Zepheus/opentherm_heating_controller/docs/BOM.md

# Andiron v1.0 — bill of materials

Generated by `tools/bom.py` from the schematic on 2026-10-22. Prices: LCSC single-unit prices from the JLCPCB parts database snapshot of 2026-10-20; they are estimates, not a quote. Upload file for JLCPCB assembly: [`bom/andiron-bom-jlc.csv`](bom/andiron-bom-jlc.csv) (fitted parts only; the placement file comes from the board).

## Cost summary

| Item | USD |
|---|---:|
| Components per board (92 placements, 39 unique parts) | 15.96 |
| Extended-part loading fees per order (13 × $3.00, assumed) | 39.00 |
| **Components per board at 5 boards, fees included** | **23.76** |

PCB fabrication, assembly setup, through-hole soldering, stencil and shipping are not included; take them from the JLCPCB quote. The Library column is what the parts database reports; "Preferred" parts carry no loading fee on Economic assembly, so only "Extended" parts are counted. Swapping an Extended part for a Basic or Preferred equivalent saves its fee.

## Fitted parts

| Qty | References | Value | Footprint | LCSC | Manufacturer part | Library | Unit | Line |
|---:|---|---|---|---|---|---|---:|---:|
| 1 | C1 | 1nF | C_0603_1608Metric | [C1588](https://jlcpcb.com/partdetail/C1588) | Samsung Electro-Mechanics CL10B102KB8NNNC | Basic | 0.0090 | 0.01 |
| 1 | C2 | 470uF/16V | CP_Elec_8x10 | [C3341](https://jlcpcb.com/partdetail/C3341) | Honor Elec RVT1C471M0810 | Extended | 0.0650 | 0.07 |
| 2 | C3, C4 | 10uF | C_0805_2012Metric | [C15850](https://jlcpcb.com/partdetail/C15850) | Samsung Electro-Mechanics CL21A106KAYNNNE | Basic | 0.0440 | 0.09 |
| 4 | C5, C7, C9, C10 | 100nF | C_0603_1608Metric | [C14663](https://jlcpcb.com/partdetail/C14663) | YAGEO CC0603KRX7R9BB104 | Basic | 0.0110 | 0.04 |
| 1 | C6 | 22uF | C_0805_2012Metric | [C45783](https://jlcpcb.com/partdetail/C45783) | Samsung Electro-Mechanics CL21A226MAQNNNE | Basic | 0.1940 | 0.19 |
| 1 | C8 | 1uF | C_0603_1608Metric | [C15849](https://jlcpcb.com/partdetail/C15849) | Samsung Electro-Mechanics CL10A105KB8NNNC | Basic | 0.0140 | 0.01 |
| 2 | D1, D2 | SMF5.0A | D_SOD-123F | [C19077497](https://jlcpcb.com/partdetail/C19077497) | hongjiacheng SMF5.0A | Preferred | 0.0280 | 0.06 |
| 8 | D101, D102, D103, D104, D201, D202, D203, D204 | 1N4148WS | D_SOD-323 | [C2128](https://jlcpcb.com/partdetail/C2128) | Jiangsu Changjing Electronics Technology Co., Ltd. 1N4148WS | Basic | 0.0150 | 0.12 |
| 1 | D205 | 4V7 BZT52C4V7 | D_SOD-123 | [C19077400](https://jlcpcb.com/partdetail/C19077400) | hongjiacheng BZT52C4V7 | Preferred | 0.0120 | 0.01 |
| 1 | D206 | 15V BZT52C15 | D_SOD-123 | [C19077412](https://jlcpcb.com/partdetail/C19077412) | hongjiacheng BZT52C15 | Preferred | 0.0180 | 0.02 |
| 1 | D207 | 4V3 BZT52C4V3 | D_SOD-123 | [C19077399](https://jlcpcb.com/partdetail/C19077399) | hongjiacheng BZT52C4V3 | Preferred | 0.0180 | 0.02 |
| 1 | D208 | SMAJ24A | D_SMA | [C19077541](https://jlcpcb.com/partdetail/C19077541) | hongjiacheng SMAJ24A | Preferred | 0.0380 | 0.04 |
| 1 | F201 | 1A 250V fast | Fuse_Littelfuse-NANO2-451_453 | [C83798](https://jlcpcb.com/partdetail/C83798) | AEM MF2410F1.000TM | Extended | 0.0930 | 0.09 |
| 1 | J1 | USB-C 16P | USB_C_Receptacle_HRO_TYPE-C-31-M-12 | [C165948](https://jlcpcb.com/partdetail/C165948) | Korean Hroparts Elec TYPE-C-31-M-12 | Extended | 0.1860 | 0.19 |
| 2 | J3, J4 | FLOW / OUTDOOR | CONN-TH_3P-P3.50_KF350-3.5-3P | [C474893](https://jlcpcb.com/partdetail/C474893) | Cixi Kefa Elec KF350-3.5-3P | Extended | 0.1550 | 0.31 |
| 2 | J5, J6 | OLED (Qwiic) GND/3V3/SDA/SCL / QWIIC | JST_SH_SM04B-SRSS-TB_1x04-1MP_P1.00mm_Horizontal | [C160404](https://jlcpcb.com/partdetail/C160404) | JST SM04B-SRSS-TB(LF)(SN) | Extended | 0.2140 | 0.43 |
| 1 | J7 | SPARE GPIO | PinHeader_1x08_P2.54mm_Vertical | [C492407](https://jlcpcb.com/partdetail/C492407) | XFCN PZ254V-11-08P | Extended | 0.0520 | 0.05 |
| 4 | J111, J112, J113, J114 | CH1 NC/COM/NO / CH2 NC/COM/NO / CH3 NC/COM/NO / CH4 NC/COM/NO | CONN-TH_3P-P5.00_WJ128V-5.0-3P | [C8270](https://jlcpcb.com/partdetail/C8270) | Ningbo Kangnex Elec WJ128V-5.0-03P-14-00A | Extended | 0.2090 | 0.84 |
| 1 | J201 | OT (24V max) | CONN-TH_P3.50_KF350-3.5-2P | [C474892](https://jlcpcb.com/partdetail/C474892) | Cixi Kefa Elec KF350-3.5-2P | Extended | 0.1190 | 0.12 |
| 4 | K101, K102, K103, K104 | RT314005 | RELAY-TH_RT314005_HF115F-PINS | [C7065270](https://jlcpcb.com/partdetail/C7065270) | TE Connectivity RT314005 | Extended | 1.8920 | 7.57 |
| 6 | LED1, LED2, LED101, LED102, LED103, LED104 | STATUS / OT_ACT / K1 / K2 / K3 / K4 | LED_0603_1608Metric | [C2286](https://jlcpcb.com/partdetail/C2286) | Hubei KENTO Elec KT-0603R | Basic | 0.0080 | 0.05 |
| 4 | Q101, Q102, Q103, Q104 | AO3400A | SOT-23 | [C20917](https://jlcpcb.com/partdetail/C20917) | Alpha & Omega Semicon AO3400A | Basic | 0.0970 | 0.39 |
| 1 | Q201 | S8550 | SOT-23 | [C105432](https://jlcpcb.com/partdetail/C105432) | Jiangsu Changjing Electronics Technology Co., Ltd. S8550(RANGE:120-200) | Basic | 0.0170 | 0.02 |
| 2 | R1, R2 | 5.1k | R_0603_1608Metric | [C23186](https://jlcpcb.com/partdetail/C23186) | UNI-ROYAL(Uniroyal Elec) 0603WAF5101T5E | Basic | 0.0020 | 0.00 |
| 1 | R3 | 1M | R_0603_1608Metric | [C22935](https://jlcpcb.com/partdetail/C22935) | UNI-ROYAL(Uniroyal Elec) 0603WAF1004T5E | Basic | 0.0020 | 0.00 |
| 6 | R4, R5, R6, R7, R9, R11 | 10k | R_0603_1608Metric | [C25804](https://jlcpcb.com/partdetail/C25804) | UNI-ROYAL(Uniroyal Elec) 0603WAF1002T5E | Basic | 0.0020 | 0.01 |
| 6 | R8, R10, R113, R123, R133, R143 | 1k | R_0603_1608Metric | [C21190](https://jlcpcb.com/partdetail/C21190) | UNI-ROYAL(Uniroyal Elec) 0603WAF1001T5E | Basic | 0.0030 | 0.02 |
| 3 | R12, R13, R14 | 4.7k | R_0603_1608Metric | [C23162](https://jlcpcb.com/partdetail/C23162) | UNI-ROYAL(Uniroyal Elec) 0603WAF4701T5E | Basic | 0.0030 | 0.01 |
| 2 | R15, R204 | 330 | R_0603_1608Metric | [C23138](https://jlcpcb.com/partdetail/C23138) | UNI-ROYAL(Uniroyal Elec) 0603WAF3300T5E | Basic | 0.0020 | 0.00 |
| 5 | R111, R121, R131, R141, R203 | 100 | R_0603_1608Metric | [C22775](https://jlcpcb.com/partdetail/C22775) | UNI-ROYAL(Uniroyal Elec) 0603WAF1000T5E | Basic | 0.0030 | 0.01 |
| 4 | R112, R122, R132, R142 | 100k | R_0603_1608Metric | [C25803](https://jlcpcb.com/partdetail/C25803) | UNI-ROYAL(Uniroyal Elec) 0603WAF1003T5E | Basic | 0.0030 | 0.01 |
| 1 | R201 | 330 | R_1206_3216Metric | [C17930](https://jlcpcb.com/partdetail/C17930) | UNI-ROYAL(Uniroyal Elec) 1206W4F3300T5E | Extended | 0.0050 | 0.01 |
| 1 | R202 | 220 | R_0603_1608Metric | [C22962](https://jlcpcb.com/partdetail/C22962) | UNI-ROYAL(Uniroyal Elec) 0603WAF2200T5E | Basic | 0.0030 | 0.00 |
| 1 | R205 | 1.5k | R_0603_1608Metric | [C22843](https://jlcpcb.com/partdetail/C22843) | UNI-ROYAL(Uniroyal Elec) 0603WAF1501T5E | Basic | 0.0020 | 0.00 |
| 4 | SW1, SW2, SW3, SW4 | RESET / BOOT / BTN1 / BTN2 | SW-SMD_4P-L5.1-W5.1-P3.70-LS6.5-TL_H1.5 | [C318884](https://jlcpcb.com/partdetail/C318884) | XKB Connection TS-1187A-B-A-B | Basic | 0.0210 | 0.08 |
| 1 | U1 | ESP32-C6-WROOM-1-N8 | WIRELM-SMD_ESP32-C6-WROOM-1 | [C5366877](https://jlcpcb.com/partdetail/C5366877) | Espressif Systems ESP32-C6-WROOM-1-N8 | Extended | 4.2330 | 4.23 |
| 1 | U2 | LDL1117S33R | SOT-223-3_TabPin2 | [C435835](https://jlcpcb.com/partdetail/C435835) | STMicroelectronics LDL1117S33R | Extended | 0.5010 | 0.50 |
| 1 | U3 | USBLC6-2SC6 | SOT-23-6 | [C7519](https://jlcpcb.com/partdetail/C7519) | STMicroelectronics USBLC6-2SC6 | Extended | 0.1770 | 0.18 |
| 2 | U201, U202 | LTV-817S (TX) / LTV-817S (RX) | OPTO-SMD-4_L4.6-W6.5-P2.54-LS10.3-BL | [C109227](https://jlcpcb.com/partdetail/C109227) | Lite-On LTV-817S-TA1-C | Basic | 0.0790 | 0.16 |

## Not fitted (DNP)

| Reference | Value | Why it is on the board |
|---|---|---|
