Zepheus/opentherm_heating_controller/docs/bom/andiron-bom-jlc.csv

Comment | Designator | Footprint | LCSC
1nF | C1 | C_0603_1608Metric | C1588
470uF/16V | C2 | CP_Elec_8x10 | C3341
10uF | C3,C4 | C_0805_2012Metric | C15850
100nF | C5,C7,C9,C10 | C_0603_1608Metric | C14663
22uF | C6 | C_0805_2012Metric | C45783
1uF | C8 | C_0603_1608Metric | C15849
SMF5.0A | D1,D2 | D_SOD-123F | C19077497
1N4148WS | D101,D102,D103,D104,D201,D202,D203,D204 | D_SOD-323 | C2128
4V7 BZT52C4V7 | D205 | D_SOD-123 | C19077400
15V BZT52C15 | D206 | D_SOD-123 | C19077412
4V3 BZT52C4V3 | D207 | D_SOD-123 | C19077399
SMAJ24A | D208 | D_SMA | C19077541
1A 250V fast | F201 | Fuse_Littelfuse-NANO2-451_453 | C83798
USB-C 16P | J1 | USB_C_Receptacle_HRO_TYPE-C-31-M-12 | C165948
FLOW / OUTDOOR | J3,J4 | CONN-TH_3P-P3.50_KF350-3.5-3P | C474893
OLED (Qwiic) GND/3V3/SDA/SCL / QWIIC | J5,J6 | JST_SH_SM04B-SRSS-TB_1x04-1MP_P1.00mm_Horizontal | C160404
SPARE GPIO | J7 | PinHeader_1x08_P2.54mm_Vertical | C492407
CH1 NC/COM/NO / CH2 NC/COM/NO / CH3 NC/COM/NO / CH4 NC/COM/NO | J111,J112,J113,J114 | CONN-TH_3P-P5.00_WJ128V-5.0-3P | C8270
OT (24V max) | J201 | CONN-TH_P3.50_KF350-3.5-2P | C474892
RT314005 | K101,K102,K103,K104 | RELAY-TH_RT314005_HF115F-PINS | C7065270
STATUS / OT_ACT / K1 / K2 / K3 / K4 | LED1,LED2,LED101,LED102,LED103,LED104 | LED_0603_1608Metric | C2286
AO3400A | Q101,Q102,Q103,Q104 | SOT-23 | C20917
S8550 | Q201 | SOT-23 | C105432
5.1k | R1,R2 | R_0603_1608Metric | C23186
1M | R3 | R_0603_1608Metric | C22935
10k | R4,R5,R6,R7,R9,R11 | R_0603_1608Metric | C25804
1k | R8,R10,R113,R123,R133,R143 | R_0603_1608Metric | C21190
4.7k | R12,R13,R14 | R_0603_1608Metric | C23162
330 | R15,R204 | R_0603_1608Metric | C23138
100 | R111,R121,R131,R141,R203 | R_0603_1608Metric | C22775
100k | R112,R122,R132,R142 | R_0603_1608Metric | C25803
330 | R201 | R_1206_3216Metric | C17930
220 | R202 | R_0603_1608Metric | C22962
1.5k | R205 | R_0603_1608Metric | C22843
RESET / BOOT / BTN1 / BTN2 | SW1,SW2,SW3,SW4 | SW-SMD_4P-L5.1-W5.1-P3.70-LS6.5-TL_H1.5 | C318884
ESP32-C6-WROOM-1-N8 | U1 | WIRELM-SMD_ESP32-C6-WROOM-1 | C5366877
LDL1117S33R | U2 | SOT-223-3_TabPin2 | C435835
USBLC6-2SC6 | U3 | SOT-23-6 | C7519
LTV-817S (TX) / LTV-817S (RX) | U201,U202 | OPTO-SMD-4_L4.6-W6.5-P2.54-LS10.3-BL | C109227
