Zepheus/opentherm_heating_controller/heating-controller.kicad_pcb

## KiCad design heating-controller.kicad_pcb (2026-10-22)

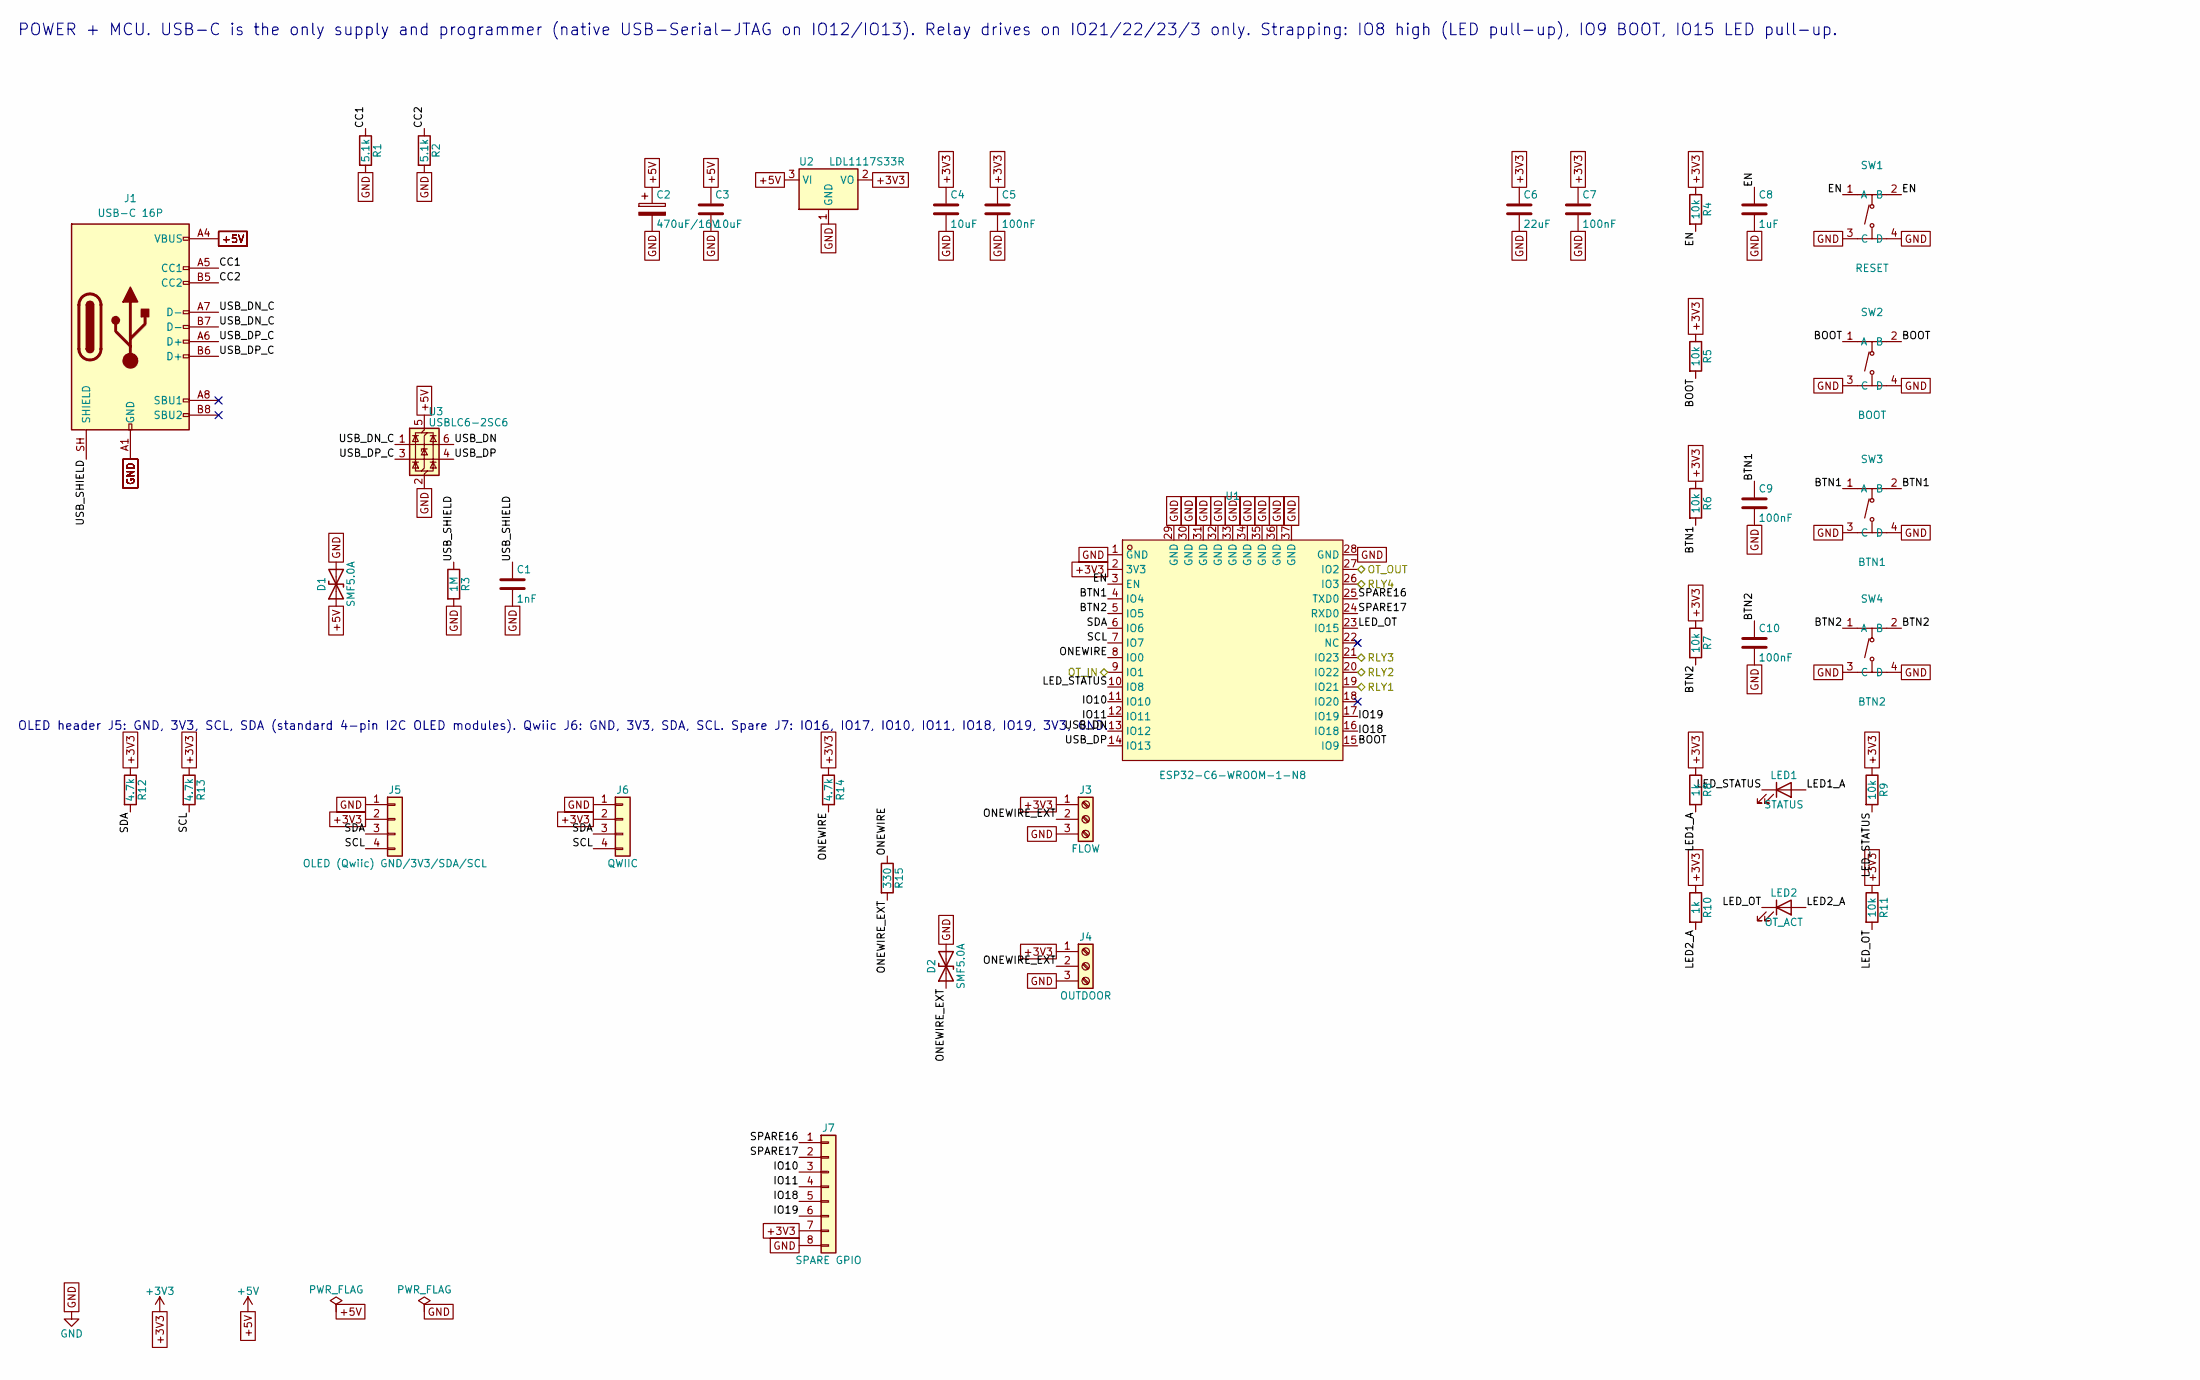
[picture p10: schematic power_mcu.kicad_sch, Andiron]

Parts:
C1: 1nF; C_0603_1608Metric; LCSC C1588
C2: 470uF/16V; CP_Elec_8x10; LCSC C3341
C3, C4: 10uF; C_0805_2012Metric; LCSC C15850
C5, C7, C9, C10: 100nF; C_0603_1608Metric; LCSC C14663
C6: 22uF; C_0805_2012Metric; LCSC C45783
C8: 1uF; C_0603_1608Metric; LCSC C15849
D1, D2: SMF5.0A; D_SOD-123F; LCSC C19077497
J1: USB-C 16P; USB_C_Receptacle_HRO_TYPE-C-31-M-12; LCSC C165948
J3: FLOW; CONN-TH_3P-P3.50_KF350-3.5-3P; LCSC C474893
J4: OUTDOOR; CONN-TH_3P-P3.50_KF350-3.5-3P; LCSC C474893
J5: OLED (Qwiic) GND/3V3/SDA/SCL; JST_SH_SM04B-SRSS-TB_1x04-1MP_P1.00mm_Horizontal; LCSC C160404
J6: QWIIC; JST_SH_SM04B-SRSS-TB_1x04-1MP_P1.00mm_Horizontal; LCSC C160404
J7: SPARE GPIO; PinHeader_1x08_P2.54mm_Vertical; LCSC C492407
LED1: STATUS; LED_0603_1608Metric; LCSC C2286
LED2: OT_ACT; LED_0603_1608Metric; LCSC C2286
R1, R2: 5.1k; R_0603_1608Metric; LCSC C23186
R3: 1M; R_0603_1608Metric; LCSC C22935
R4, R5, R6, R7, R9, R11: 10k; R_0603_1608Metric; LCSC C25804
R8, R10: 1k; R_0603_1608Metric; LCSC C21190
R12, R13, R14: 4.7k; R_0603_1608Metric; LCSC C23162
R15: 330; R_0603_1608Metric; LCSC C23138
SW1: RESET; SW-SMD_4P-L5.1-W5.1-P3.70-LS6.5-TL_H1.5; LCSC C318884
SW2: BOOT; SW-SMD_4P-L5.1-W5.1-P3.70-LS6.5-TL_H1.5; LCSC C318884
SW3: BTN1; SW-SMD_4P-L5.1-W5.1-P3.70-LS6.5-TL_H1.5; LCSC C318884
SW4: BTN2; SW-SMD_4P-L5.1-W5.1-P3.70-LS6.5-TL_H1.5; LCSC C318884
U1: ESP32-C6-WROOM-1-N8; WIRELM-SMD_ESP32-C6-WROOM-1; LCSC C5366877
U2: LDL1117S33R; SOT-223-3_TabPin2; LCSC C435835
U3: USBLC6-2SC6; SOT-23-6; LCSC C7519

Connections:
+3V3: C4.1, C5.1, C6.1, C7.1, J3.1, J4.1, J5.2, J6.2, J7.7, R4.1, R5.1, R6.1, R7.1, R8.1, R9.1, R10.1, R11.1, R12.1, R13.1, R14.1, U1.2 (3V3), U2.2 (VO); also elsewhere on the board
/OT_IN: U1.9 (IO1); also elsewhere on the board
/OT_OUT: U1.27 (IO2); also elsewhere on the board
/Power + MCU/BOOT: R5.2, SW2.1 (A), SW2.2 (B), U1.15 (IO9)
/Power + MCU/BTN1: C9.1, R6.2, SW3.1 (A), SW3.2 (B), U1.4 (IO4)
/Power + MCU/BTN2: C10.1, R7.2, SW4.1 (A), SW4.2 (B), U1.5 (IO5)
/Power + MCU/CC1: J1.A5 (CC1), R1.1
/Power + MCU/CC2: J1.B5 (CC2), R2.1
/Power + MCU/EN: C8.1, R4.2, SW1.1 (A), SW1.2 (B), U1.3 (EN)
/Power + MCU/IO10: J7.3, U1.11 (IO10)
/Power + MCU/IO11: J7.4, U1.12 (IO11)
/Power + MCU/IO18: J7.5, U1.16 (IO18)
/Power + MCU/IO19: J7.6, U1.17 (IO19)
/Power + MCU/LED1_A: LED1.2 (A), R8.2
/Power + MCU/LED2_A: LED2.2 (A), R10.2
/Power + MCU/LED_OT: LED2.1 (K), R11.2, U1.23 (IO15)
/Power + MCU/LED_STATUS: LED1.1 (K), R9.2, U1.10 (IO8)
/Power + MCU/ONEWIRE: R14.2, R15.1, U1.8 (IO0)
/Power + MCU/ONEWIRE_EXT: D2.1 (A1), J3.2, J4.2, R15.2
/Power + MCU/SCL: J5.4, J6.4, R13.2, U1.7 (IO7)
/Power + MCU/SDA: J5.3, J6.3, R12.2, U1.6 (IO6)
/Power + MCU/SPARE16: J7.1, U1.25 (TXD0)
/Power + MCU/SPARE17: J7.2, U1.24 (RXD0)
/Power + MCU/USB_DN: U1.13 (IO12), U3.6 (I/O1)
/Power + MCU/USB_DN_C: J1.A7 (D-), J1.B7 (D-), U3.1 (I/O1)
/Power + MCU/USB_DP: U1.14 (IO13), U3.4 (I/O2)
/Power + MCU/USB_DP_C: J1.A6 (D+), J1.B6 (D+), U3.3 (I/O2)
/Power + MCU/USB_SHIELD: C1.1, J1.SH (SHIELD), R3.1
/RLY1: U1.19 (IO21); also elsewhere on the board
/RLY2: U1.20 (IO22); also elsewhere on the board
/RLY3: U1.21 (IO23); also elsewhere on the board
/RLY4: U1.26 (IO3); also elsewhere on the board

Notes on the sheet:
POWER + MCU. USB-C is the only supply and programmer (native USB-Serial-JTAG on IO12/IO13). Relay drives on IO21/22/23/3 only. Strapping: IO8 high (LED pull-up), IO9 BOOT, IO15 LED pull-up.
OLED header J5: GND, 3V3, SCL, SDA (standard 4-pin I2C OLED modules). Qwiic J6: GND, 3V3, SDA, SCL. Spare J7: IO16, IO17, IO10, IO11, IO18, IO19, 3V3, GND.

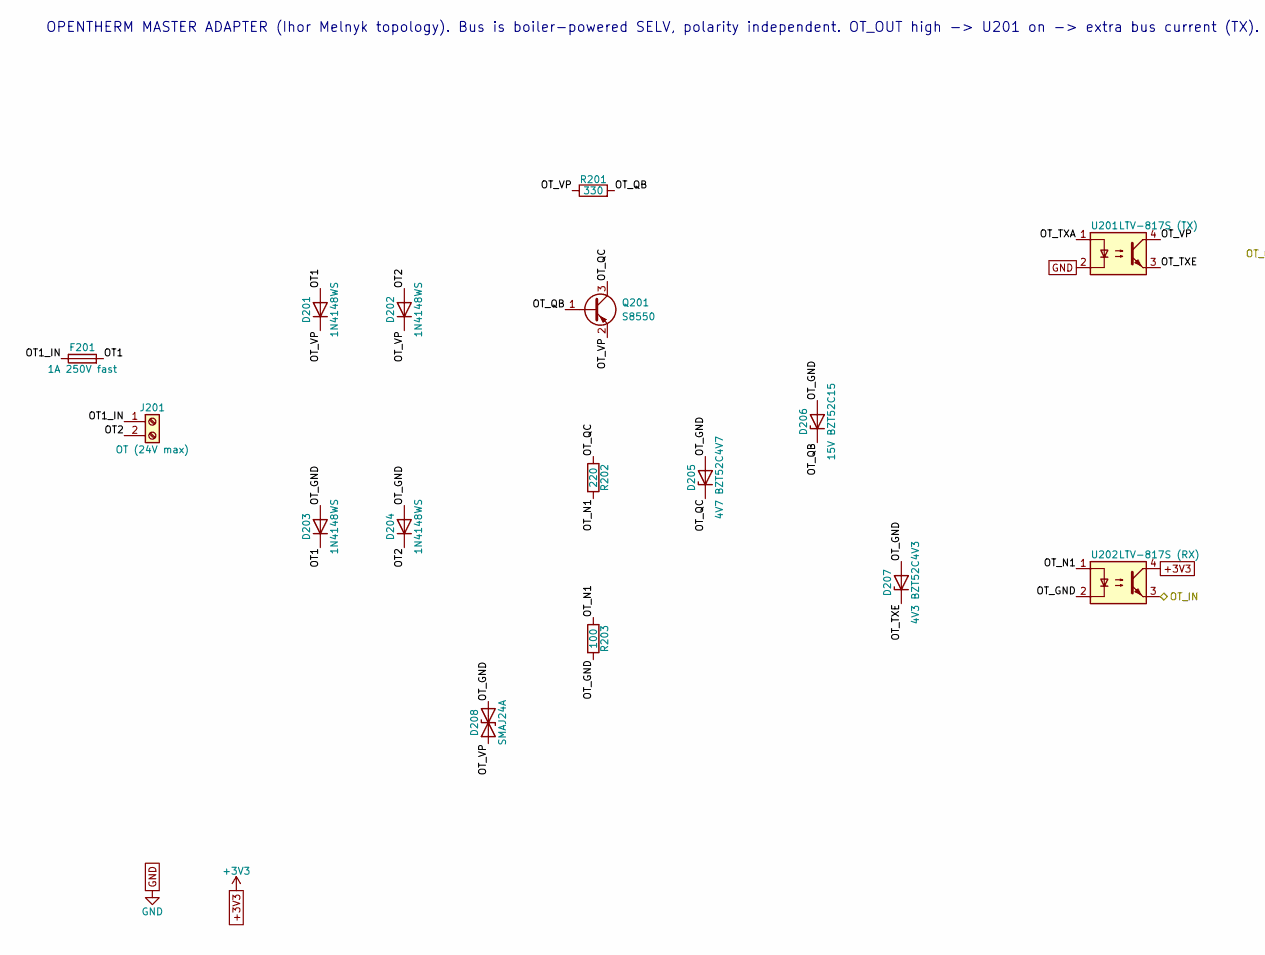
[picture p11: schematic opentherm.kicad_sch, Andiron, part in row 1, column 1]

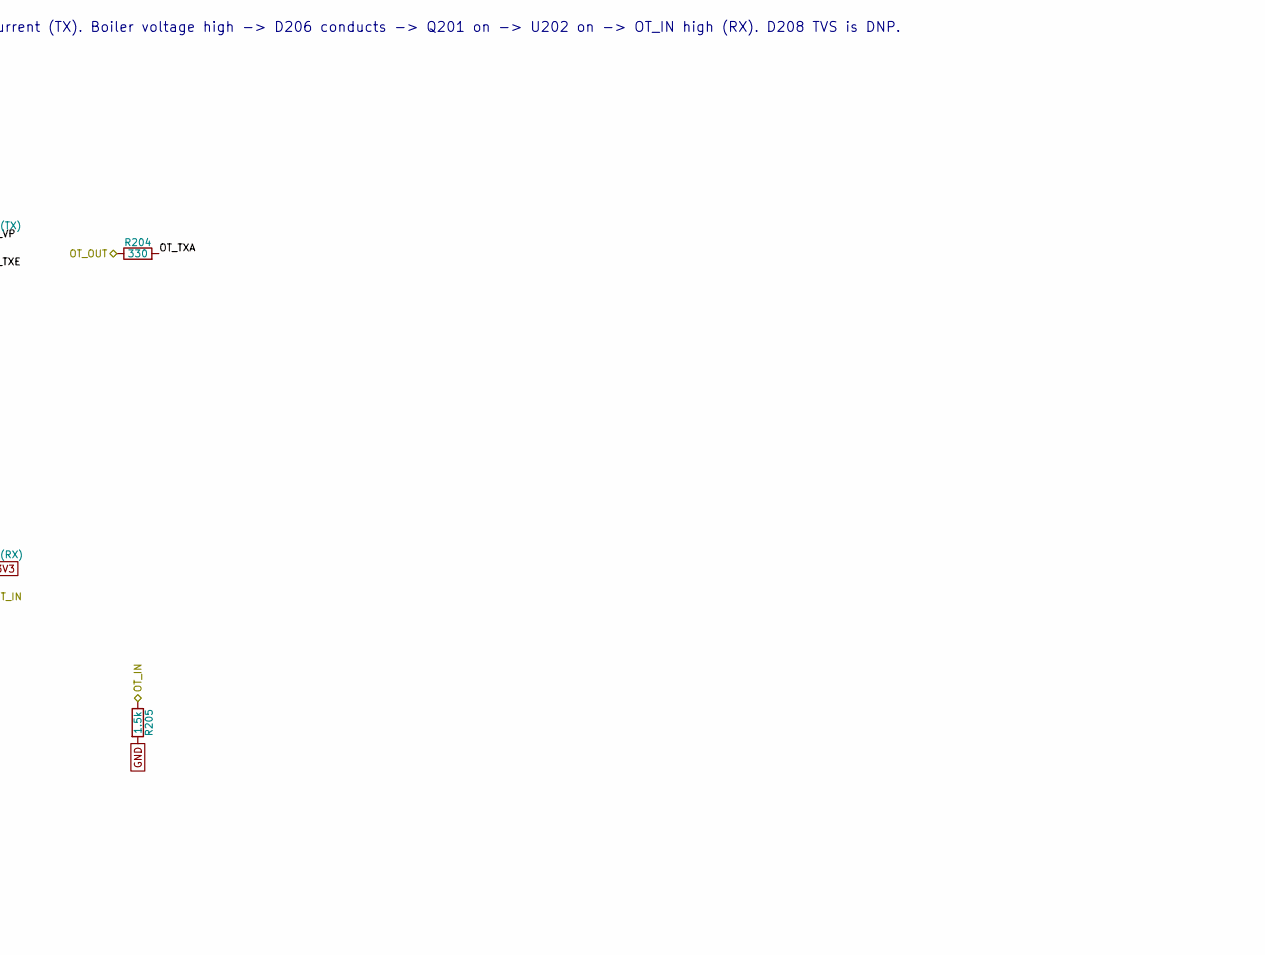
[picture p12: schematic opentherm.kicad_sch, Andiron, part in row 1, column 2]

Parts:
D201, D202, D203, D204: 1N4148WS; D_SOD-323; LCSC C2128
D205: 4V7 BZT52C4V7; D_SOD-123; LCSC C19077400
D206: 15V BZT52C15; D_SOD-123; LCSC C19077412
D207: 4V3 BZT52C4V3; D_SOD-123; LCSC C19077399
D208: SMAJ24A; D_SMA; LCSC C19077541
F201: 1A 250V fast; Fuse_Littelfuse-NANO2-451_453; LCSC C83798
J201: OT (24V max); CONN-TH_P3.50_KF350-3.5-2P; LCSC C474892
Q201: S8550; SOT-23; LCSC C105432
R201: 330; R_1206_3216Metric; LCSC C17930
R202: 220; R_0603_1608Metric; LCSC C22962
R203: 100; R_0603_1608Metric; LCSC C22775
R204: 330; R_0603_1608Metric; LCSC C23138
R205: 1.5k; R_0603_1608Metric; LCSC C22843
U201: LTV-817S (TX); OPTO-SMD-4_L4.6-W6.5-P2.54-LS10.3-BL; LCSC C109227
U202: LTV-817S (RX); OPTO-SMD-4_L4.6-W6.5-P2.54-LS10.3-BL; LCSC C109227

Connections:
+3V3: U202.4; also elsewhere on the board
/OT_IN: R205.1, U202.3; also elsewhere on the board
/OT_OUT: R204.1; also elsewhere on the board
/OpenTherm/OT1: D201.2 (A), D203.1 (K), F201.2
/OpenTherm/OT1_IN: F201.1, J201.1
/OpenTherm/OT2: D202.2 (A), D204.1 (K), J201.2
/OpenTherm/OT_GND: D203.2 (A), D204.2 (A), D205.2 (A), D206.2 (A), D207.2 (A), D208.2 (A2), R203.2, U202.2
/OpenTherm/OT_N1: R202.2, R203.1, U202.1
/OpenTherm/OT_QB: D206.1 (K), Q201.1 (B), R201.2
/OpenTherm/OT_QC: D205.1 (K), Q201.3 (C), R202.1
/OpenTherm/OT_TXA: R204.2, U201.1
/OpenTherm/OT_TXE: D207.1 (K), U201.3
/OpenTherm/OT_VP: D201.1 (K), D202.1 (K), D208.1 (A1), Q201.2 (E), R201.1, U201.4

Notes on the sheet:
OPENTHERM MASTER ADAPTER (Ihor Melnyk topology). Bus is boiler-powered SELV, polarity independent. OT_OUT high -> U201 on -> extra bus current (TX). Boiler voltage high -> D206 conducts -> Q201 on -> U202 on -> OT_IN high (RX). D208 TVS is DNP.

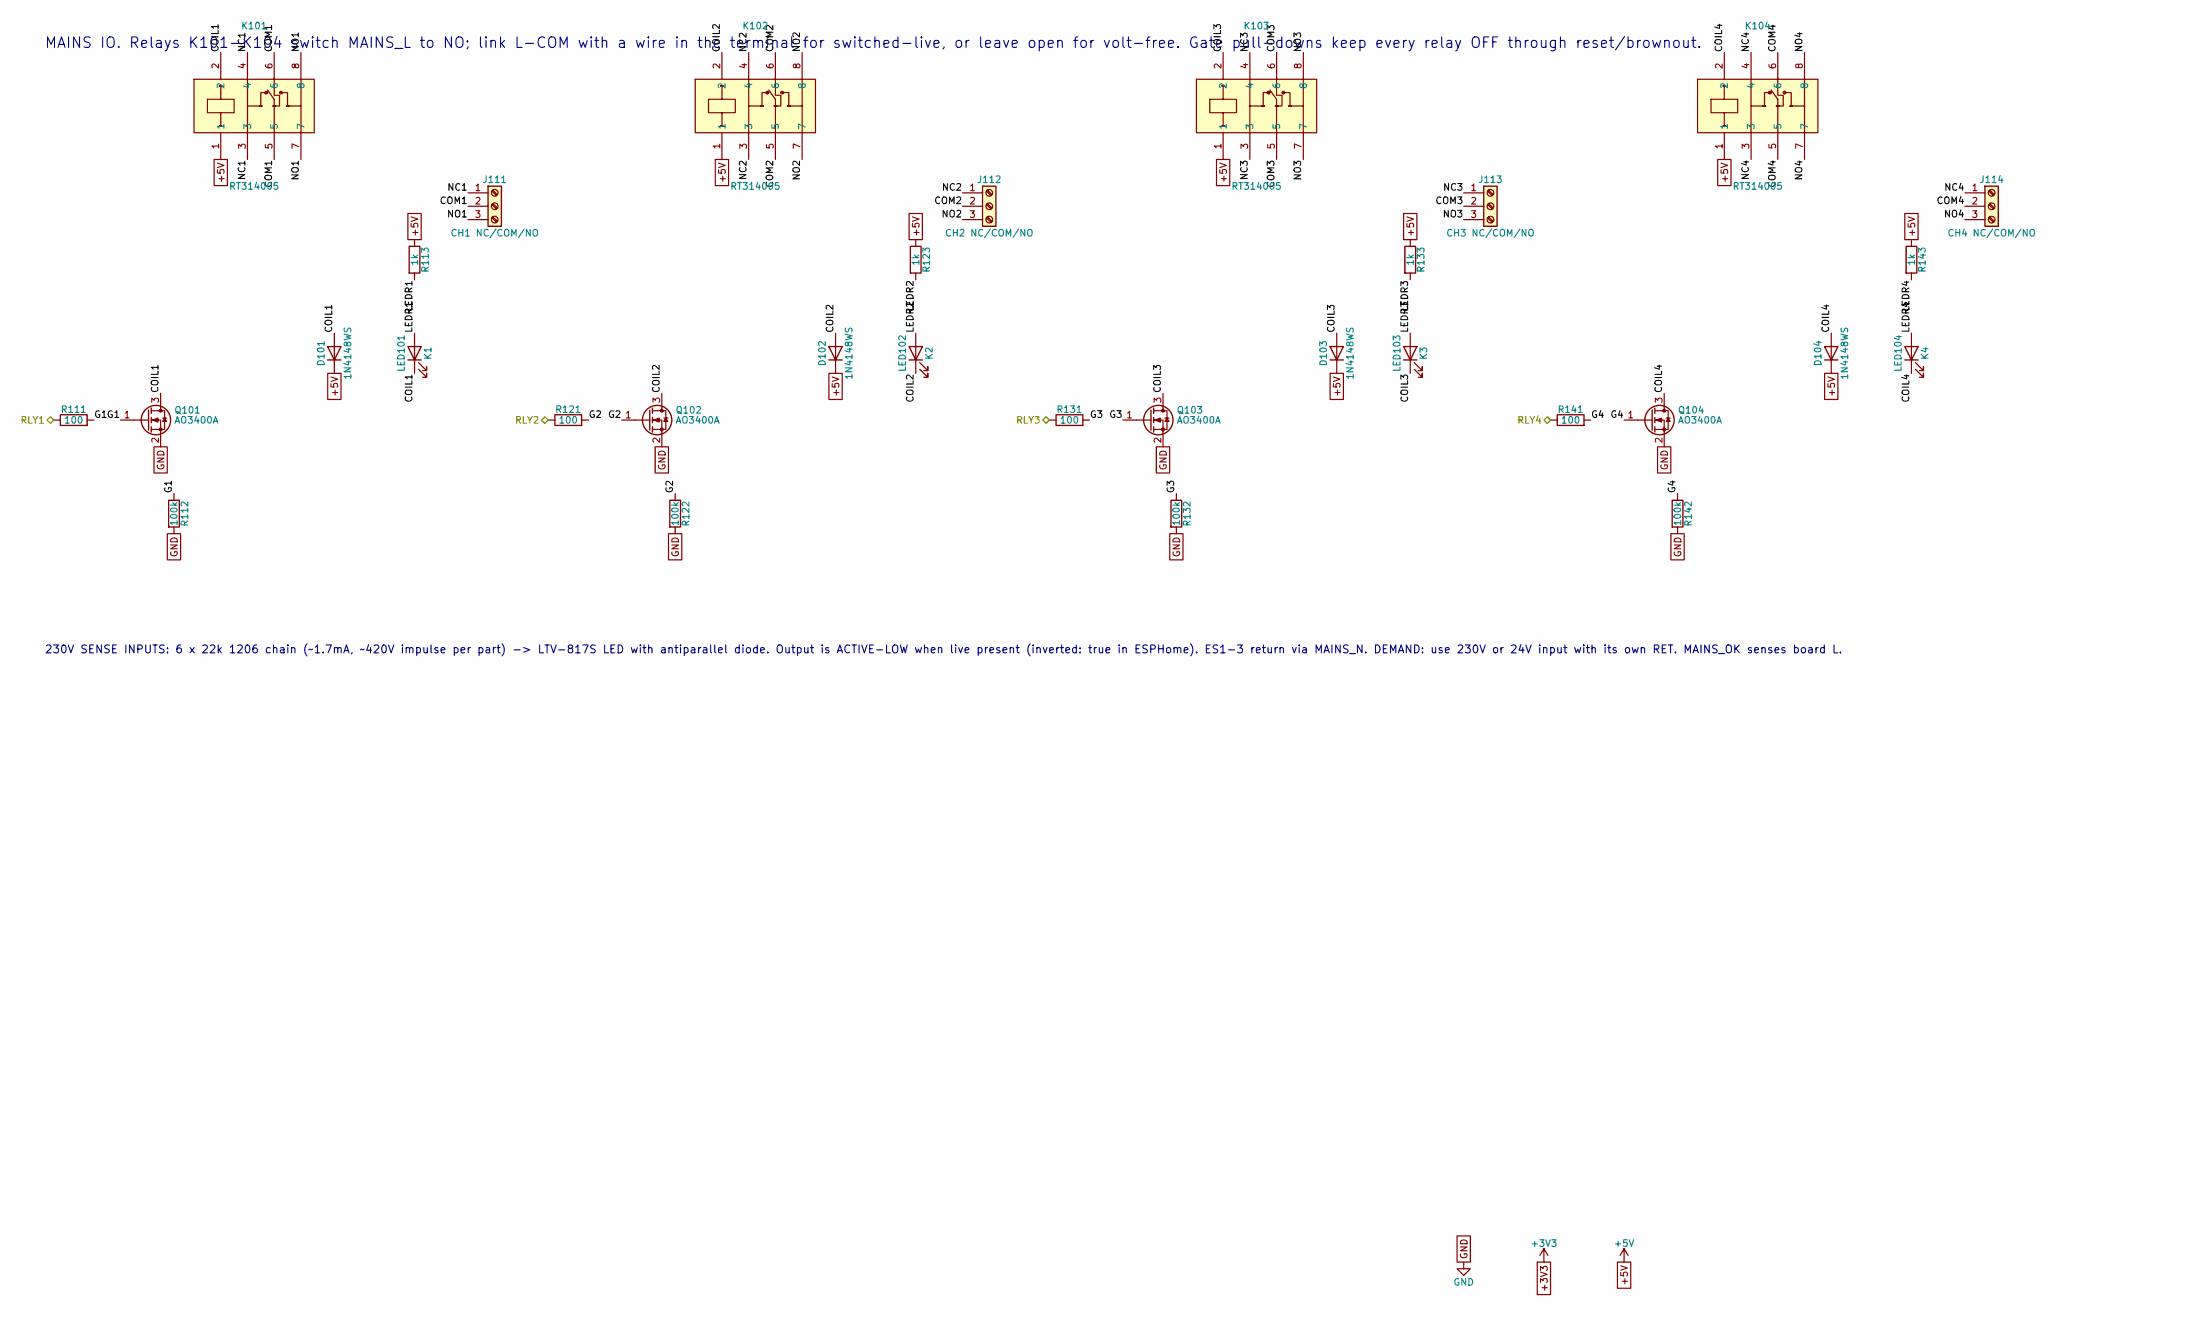
[picture p13: schematic relays.kicad_sch, Andiron]

Parts:
D101, D102, D103, D104: 1N4148WS; D_SOD-323; LCSC C2128
J111: CH1 NC/COM/NO; CONN-TH_3P-P5.00_WJ128V-5.0-3P; LCSC C8270
J112: CH2 NC/COM/NO; CONN-TH_3P-P5.00_WJ128V-5.0-3P; LCSC C8270
J113: CH3 NC/COM/NO; CONN-TH_3P-P5.00_WJ128V-5.0-3P; LCSC C8270
J114: CH4 NC/COM/NO; CONN-TH_3P-P5.00_WJ128V-5.0-3P; LCSC C8270
K101, K102, K103, K104: RT314005; RELAY-TH_RT314005_HF115F-PINS; LCSC C7065270
LED101: K1; LED_0603_1608Metric; LCSC C2286
LED102: K2; LED_0603_1608Metric; LCSC C2286
LED103: K3; LED_0603_1608Metric; LCSC C2286
LED104: K4; LED_0603_1608Metric; LCSC C2286
Q101, Q102, Q103, Q104: AO3400A; SOT-23; LCSC C20917
R111, R121, R131, R141: 100; R_0603_1608Metric; LCSC C22775
R112, R122, R132, R142: 100k; R_0603_1608Metric; LCSC C25803
R113, R123, R133, R143: 1k; R_0603_1608Metric; LCSC C21190

Connections:
/RLY1: R111.1; also elsewhere on the board
/RLY2: R121.1; also elsewhere on the board
/RLY3: R131.1; also elsewhere on the board
/RLY4: R141.1; also elsewhere on the board
/Relays/COIL1: D101.2 (A), K101.2, LED101.1 (K), Q101.3 (D)
/Relays/COIL2: D102.2 (A), K102.2, LED102.1 (K), Q102.3 (D)
/Relays/COIL3: D103.2 (A), K103.2, LED103.1 (K), Q103.3 (D)
/Relays/COIL4: D104.2 (A), K104.2, LED104.1 (K), Q104.3 (D)
/Relays/COM1: J111.2, K101.5, K101.6
/Relays/COM2: J112.2, K102.5, K102.6
/Relays/COM3: J113.2, K103.5, K103.6
/Relays/COM4: J114.2, K104.5, K104.6
/Relays/G1: Q101.1 (G), R111.2, R112.1
/Relays/G2: Q102.1 (G), R121.2, R122.1
/Relays/G3: Q103.1 (G), R131.2, R132.1
/Relays/G4: Q104.1 (G), R141.2, R142.1
/Relays/LEDR1: LED101.2 (A), R113.2
/Relays/LEDR2: LED102.2 (A), R123.2
/Relays/LEDR3: LED103.2 (A), R133.2
/Relays/LEDR4: LED104.2 (A), R143.2
/Relays/NC1: J111.1, K101.3, K101.4
/Relays/NC2: J112.1, K102.3, K102.4
/Relays/NC3: J113.1, K103.3, K103.4
/Relays/NC4: J114.1, K104.3, K104.4
/Relays/NO1: J111.3, K101.7, K101.8
/Relays/NO2: J112.3, K102.7, K102.8
/Relays/NO3: J113.3, K103.7, K103.8
/Relays/NO4: J114.3, K104.7, K104.8

Notes on the sheet:
MAINS IO. Relays K101-K104 switch MAINS_L to NO; link L-COM with a wire in the terminal for switched-live, or leave open for volt-free. Gate pull-downs keep every relay OFF through reset/brownout.
230V SENSE INPUTS: 6 x 22k 1206 chain (~1.7mA, ~420V impulse per part) -> LTV-817S LED with antiparallel diode. Output is ACTIVE-LOW when live present (inverted: true in ESPHome). ES1-3 return via MAINS_N. DEMAND: use 230V or 24V input with its own RET. MAINS_OK senses board L.

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
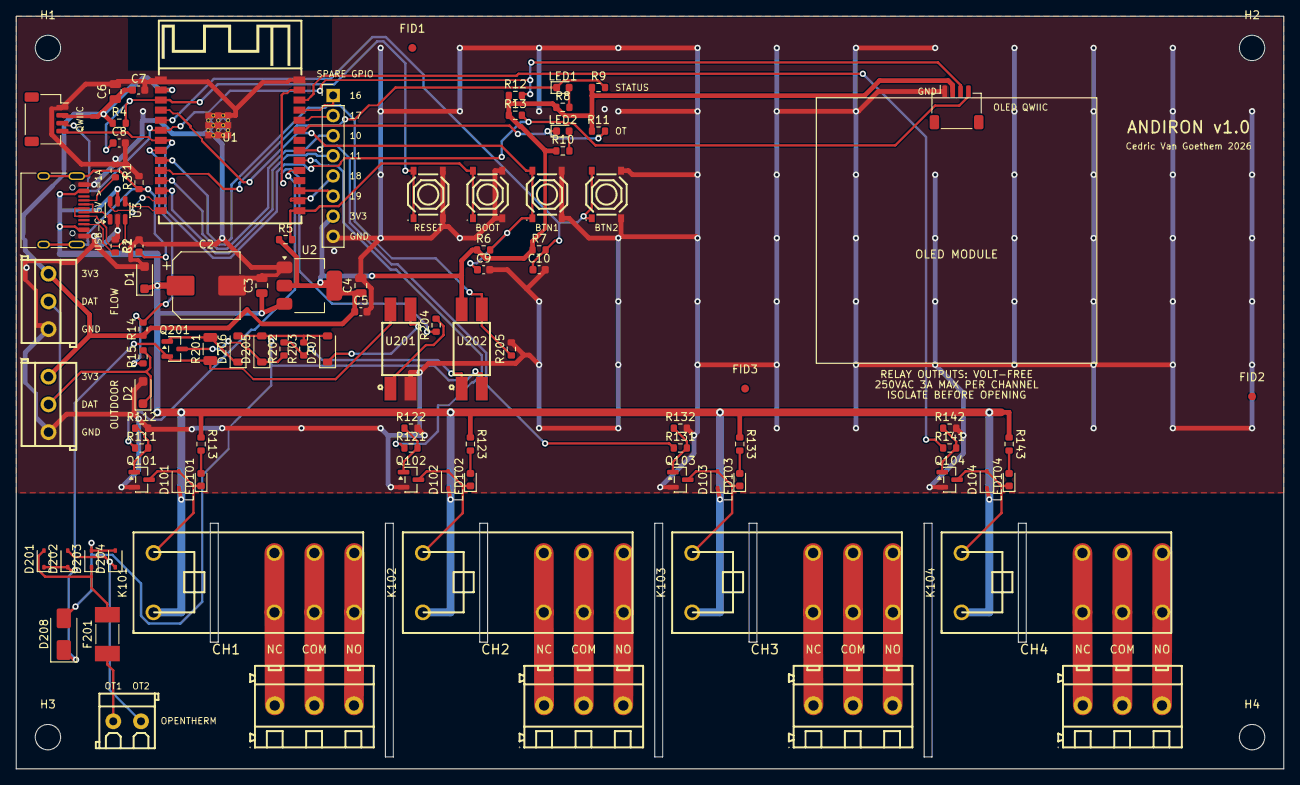
[picture p14: board heating-controller.kicad_pcb from above]

Board: 2 copper layers, 160.0 x 95.0 mm, 99 parts (0 on the bottom side), 68 nets.

Other parts of the board:
FID1, FID2, FID3: Fiducial_1mm_Mask3mm
H1, H2, H3, H4: MountingHole_3.2mm_M3
