Zepheus/opentherm_heating_controller/(commit log)

2026-10-20 Initial schematic: ESP32-C6 heating controller
    OpenTherm master adapter, 4x 230V zone-valve relays (3 fitted), 5x
    opto-isolated 230V sense inputs, USB-C power/programming, OLED, buttons,
    1-Wire probes. Requirements, design brief (rev 6), schematic plan, project
    library generated from JLC data, Konnect design rules. ERC clean.
2026-10-20 Place and autoroute the board; add the reproducible routing pipeline
    Board 150 x 95 mm, 2-layer, routed with Freerouting 2.5 from a placed
    layout: DRC 0 violations / 0 unconnected, schematic parity clean, ERC clean.
    - Isolation band, antenna keep-out, relay/opto slots, 6.4 mm mains-to-SELV
    custom DRC (heating-controller.kicad_dru) and MAINS / MAINS_SENSE / Power
    net classes in the project file.
    - Fixed wiring laid before routing: L/N buses, relay COM/NO links,
    DEMAND_RET return, USB-C D+/D- bridges and VBUS escape, 31 GND stitching
    vias so the bottom pour stays in one piece.
    - J115/J116 moved in from the board edge so every courtyard is inside the
    outline (JLC assembly margin).
    -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
2026-10-21 Address the independent design review: OT net split and fuse, 2.0 mm live-input class, demand detector margin, 3V3 copper, silkscreen
    Two review rounds closed with design changes rather than prose:
    - OpenTherm: U201 emitter and D207 cathode moved off OT_N1 onto OT_TXE
    (the net merge echoed our own TX into the RX opto); D208 SMAJ24A fitted;
    F201 1 A 250 V fast 2410 fuse in series with OT1 so a 230 V miswire is a
    calculable TVS-plus-fuse crowbar instead of parts failing open.
    - Raw live inputs (ES1-3_IN, DEMAND_230) in a MAINS_IN class at 2.0 mm to
    everything, included in the 6.4 mm and edge rules; mains-to-mains 2.0 mm;
    the four inputs are pre-routed as locked lanes (the autorouter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
2026-10-22 Name the board Andiron v1.0; add BOM with cost estimates, renders, getting-started docs and CLAUDE.md
    - Andiron v1.0 and the author name on the silkscreen, in every title block
    and in the README; J116 warning moved inside the board edge.
    - tools/bom.py: BOM from the schematic with LCSC prices from the Konnect
    JLCPCB database -> docs/BOM.md (cost summary, Basic/Extended, DNP list) and
    docs/bom/andiron-bom-jlc.csv (JLCPCB upload). ~$15.77 components per board,
    ~$28.97 per board at 5 including assumed Extended-part fees.
    - tools/sync_models.py relinks all 152 footprints to 3D models with portable
    ${KIPRJMOD} paths (also fixed in lib/jlc.pretty); stand-ins for the
    ESP32-C6 module and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
2026-10-22 Final sanity pass: decoupling moved to the module pin, spacing spec checked every run, creepage DRC, licence, README for humans
    Sanity check (pinouts, connectivity, routing, manufacturability):
    - ESP32-C6-WROOM-1 pin table, USB D-/D+ on GPIO12/13, strapping pins
    (GPIO8/9/15 pulled up, EN 10k/1uF) and every active/polarised part's
    pinout verified against datasheets; no changes needed.
    - Decoupling: C6 (22uF) and C7 (100nF) moved from 17/13 mm to 3.0/1.5 mm
    from the module's 3V3 pin. The pipeline now starts from the committed
    placed board tools/route/placed.kicad_pcb.
    - Creepage rule (6.4 mm mains-to-SELV, follows slots) added to the DRC file;
    verified live by tightening it until it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
2026-10-22 Andiron v1.0 redesign: volt-free changeover relays, no mains sensing, layout by module area
    - Relays: four HF115F/005-1ZS3A changeover relays (CH1-CH4), each with its own
    NC/COM/NO terminal, as UK heating controllers present their outputs; 5 kV
    VDE-reinforced coil-to-contact insulation. Each channel is its own net class
    and keeps 6.4 mm clearance and creepage from everything that is not itself.
    - Removed the 230 V supply input, L/N rails and all five mains sensing inputs
    (30 resistors, 5 optos, end-switch and demand terminals). The only mains on
    the board is the relay contacts.
    - Power: LDL1117S33R replaces the AMS1117 (0.35 V dropout, ceramic-stable,
    18 V abs-max, no heat-spread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
2026-10-22 Wall-hanging layout, cheaper parts, OLED area
    Layout (160 x 95 mm): the board hangs on a wall with every cable from below
    or the left. Relay and OpenTherm terminals on the bottom edge, USB-C, FLOW,
    OUTDOOR and Qwiic on the left edge, antenna at the top edge. The OLED module
    stacks in landscape over a reserved top-right area.
    Parts: TE RT314005 relays replace the HF115F (same body and pin grid,
    reinforced 5 kV / 10 mm insulation, flux-proof so no washing after THT); AEM
    MF2410F1.000TM fast fuse replaces the Bourns (same breaking capacity and
    I2t, Bourns nearly out of stock); Basic 100 nF and 1 uF capacitors.
    Per-board total at 5: $37.23 -> $27.86 (components $24.03 -> $15.86).
    Tooling: lock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
2026-10-22 JLC package, placement corrections, Preferred-part swaps
    - tools/fab.sh builds the JLCPCB package in fab/jlc/: Gerbers and drill
    zip, BOM copy and a placement file from tools/cpl.py.
    - tools/cpl.py applies JLC's orientation conventions per footprint
    (SOT-23/SOT-223 180°, SOT-23-6 -90°, pin headers 90° at the pad centre,
    USB-C at the pad centre), each checked in JLC's placement viewer.
    - D1/D2 (SMF5.0A), D208 (SMAJ24A) and D205-D207 (BZT52) moved to the same
    part types from JLC's Preferred library: no Extended-part fee on Economic
    assembly. Datasheets checked; footprints unchanged, no rerouting.
    - TVS descriptions corrected to unidirectional.
    - bom.py no longer charges the fee on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
2026-10-22 OLED on a Qwiic cable, boot jumper removed, enclosure re-sized
    - J5 (OLED) is a Qwiic socket, same part as J6, in Qwiic order GND / 3V3 /
    SDA / SCL on GPIO6/GPIO7 (hardware I2C). The module sits in the cover
    window on a short cable (JST-SH to Dupont, or a soldered pigtail); the
    2.9 mm socket replaces a header that needed ~20 mm with Dupont housings.
    - J8 (boot jumper) removed from schematic and board: the BOOT button does
    the same.
    - Enclosure section rewritten: ~170 x 135 x 32 mm with a mains wiring bay
    (cable clamps, OT/mains rib), standoffs and support posts, USB-C wall
    relief, lid plungers for BTN1/BTN2.
    - route_board.py no longer drops a stitching via that a GND track ends o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
2026-10-29 ESPHome firmware: bring-up config and first full config
    andiron-bringup.yaml exposes every I/O as a plain entity; flashed and
    verified on a v1.0 board (relays, LEDs, buttons, I2C and 1-Wire buses).
    andiron.yaml adds the OpenTherm master with the Vitodens 100-W quirks
    (hub enable flags, synthetic max modulation and room values), the R8.6
    failsafe, the OT activity LED and the SH1106 OLED with burn-in measures.
    Secrets stay in the gitignored firmware/secrets.yaml.
    Claude-Session: https://claude.ai/code/session_01XDSh2Z4phxf7z2Gu1153CL
